aryankumar1704/Mini-Project-Design-of-closed-loop-boost-converter-PCB/WhatsApp Image 2026-04-29 at 2.35.51 PM.jpeg

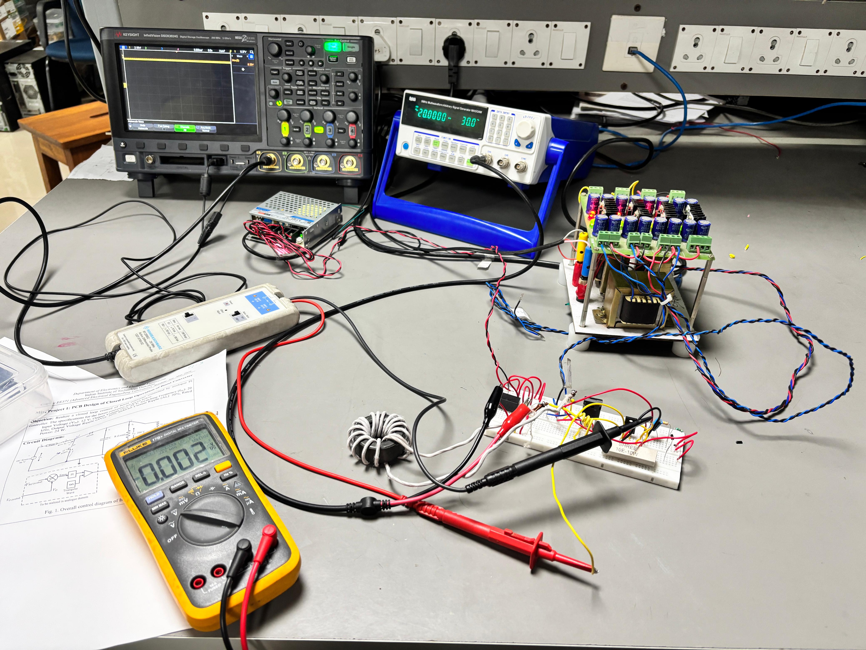
WhatsApp Image 2026-04-29 at 2.35.51 PM.jpeg
