aryankumar1704/Mini-Project-Design-of-closed-loop-boost-converter-PCB/CLBC.asc

1N4007: diode
C1: cap; 12µf
C2: cap; 0.1µf
C3: cap; 10nf
C4: cap; 10nf
DR: zener
L1: ind; 0.75mH
M1: nmos; IRF740 NMOS
MUR1560: diode
R1: res; 24
R2: res; 91k
R3: res; 1.6k
R4: res; 2.2k
R5: res; 2.2k
R6: res; 2.2k
R7: res; 10k
R8: res; 20K
R9: res; 2.2k
R10: res; 10k
R11: res; 2.2k
R12: res; 2.2k
R13: res; 47k
R14: res; 690k
R15: res; 10k
R16: res; 2.2k
R17: res; 2.2k
R18: res; 2.2k
R19: res; 5K
R20: res; 2k
R21: res; 2.2k
R22: res; 2.2k
R: res; 10k
U1: opamp2; TL064
U2: opamp2; TL064
U3: opamp2; TL064
U4: opamp2; TL064
U5: opamp2; TL064
U6: opamp2; TL064
U7: opamp2; TL064
U8: opamp2; TL064
V1: voltage; 12
V2: voltage; 15
V3: voltage; -15
V4: voltage; -1.25
Vref: voltage; -0.414
Named nets: 0, Vo, Ve, P, I, Vc, Vt, +15, -15, Vg
.model IRF740 NMOS(Level=3 Gamma=0 Delta=0 Eta=0 Theta=0 Kappa=0.2 Vmax=0 Xj=0
+ Tox=100n Uo=600 Phi=.6 Rs=8.563m Kp=20.59u W=.78 L=2u Vto=3.657
+ Rd=.3915 Rds=1.778MEG Cbd=1.419n Pb=.8 Mj=.5 Fc=.5 Cgso=1.392n
+ Cgdo=146.6p Rg=.9088 Is=17.65p N=1 Tt=570n)
* IR pid=IRF740 case=TO220
.model MUR1560 D(Is=95.51p Rs=46.69m Ikf=8.883m N=1 Xti=6 Eg=1.11 Cjo=525.4p M=.414 Vj=.75 Fc=.5 Isr=251.2n Nr=2 Tt=148n type=silicon)
.model 1N4007 D(IS=7.02767n RS=0.0341512 N=1.80803 EG=1.05743 XTI=5 BV=1000 IBV=5e-08 CJO=1e-11 VJ=0.7 M=0.5 FC=0.5 TT=1e-07 mfg=OnSemi type=silicon)
*SRC=1N4759A;DI_1N4759A;Diodes;Zener >50V; 62.0V  1.00W   Diodes Inc. Zener
*SYM=HZEN
.SUBCKT DI_1N4759A  1 2
*        Terminals    A   K
D1 1 2 DF
DZ 3 1 DR
VZ 2 3 59.7
.MODEL DF D ( IS=6.65p RS=0.620 N=1.10
+ CJO=30.3p VJ=1.00 M=0.330 TT=50.1n )
.MODEL DR D ( IS=1.33f RS=19.6 N=3.00 )
.ENDS
* TL064 OPERATIONAL AMPLIFIER "MACROMODEL" SUBCIRCUIT
* CREATED USING PARTS RELEASE 4.01 ON 06/28/89 AT 10:42
* (REV N/A)      SUPPLY VOLTAGE: +/-15V
* CONNECTIONS:   NON-INVERTING INPUT
*                | INVERTING INPUT
*                | | POSITIVE POWER SUPPLY
*                | | | NEGATIVE POWER SUPPLY
*                | | | | OUTPUT
*                | | | | |
.SUBCKT TL064    1 2 3 4 5
*
  C1   11 12 3.498E-12
  C2    6  7 15.00E-12
  DC    5 53 DX
  DE   54  5 DX
  DLP  90 91 DX
  DLN  92 90 DX
  DP    4  3 DX
  EGND 99  0 POLY(2) (3,0) (4,0) 0 .5 .5
  FB    7 99 POLY(5) VB VC VE VLP VLN 0 318.3E3 -300E3 300E3 300E3 -300E3
  GA    6  0 11 12 94.26E-6
  GCM 0  6 10 99 1.607E-9
  ISS   3 10 DC 52.50E-6
  HLIM 90  0 VLIM 1K
  J1   11  2 10 JX
  J2   12  1 10 JX
  R2    6  9 100.0E3
  RD1   4 11 10.61E3
  RD2   4 12 10.61E3
  RO1   8  5 200
  RO2   7 99 200
  RP    3  4 150.0E3
  RSS  10 99 3.810E6
  VB    9  0 DC 0
  VC    3 53 DC 2.200
  VE   54  4 DC 2.200
  VLIM  7  8 DC 0
  VLP  91  0 DC 15
  VLN   0 92 DC 15
.MODEL DX D(IS=800.0E-18)
.MODEL JX PJF(IS=15.00E-12 BETA=100.5E-6 VTO=-1)
.ENDS
.tran 1
